agleason6/Street-Solar-Charger/inductor.jpg

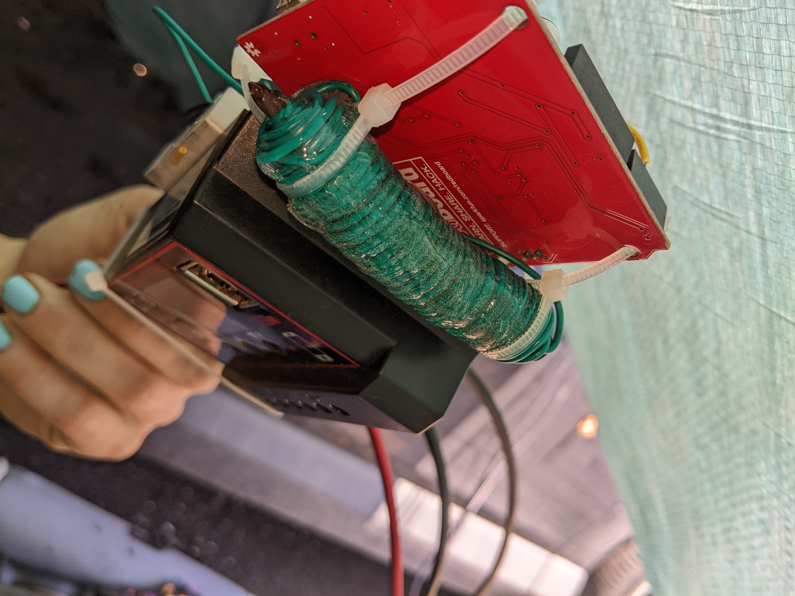
inductor.jpg
