agleason6/Street-Solar-Charger/circuit.jpg

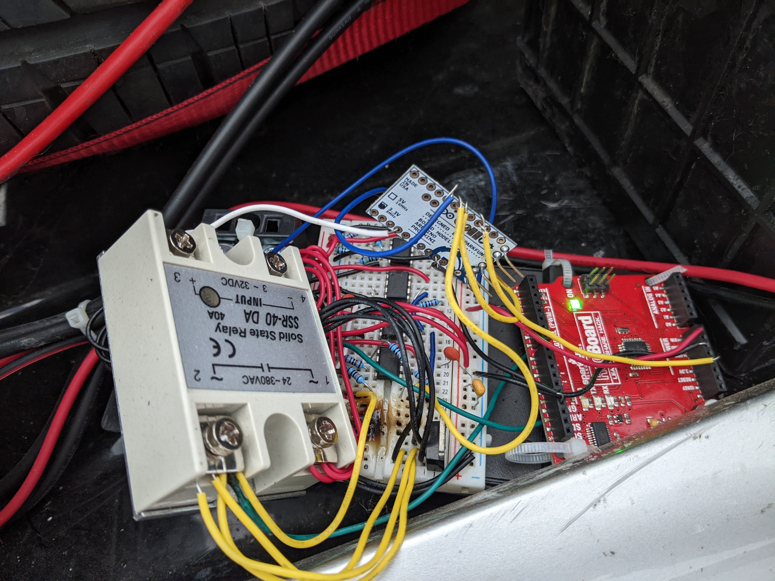
circuit.jpg
