agleason6/Street-Solar-Charger/overall.jpg

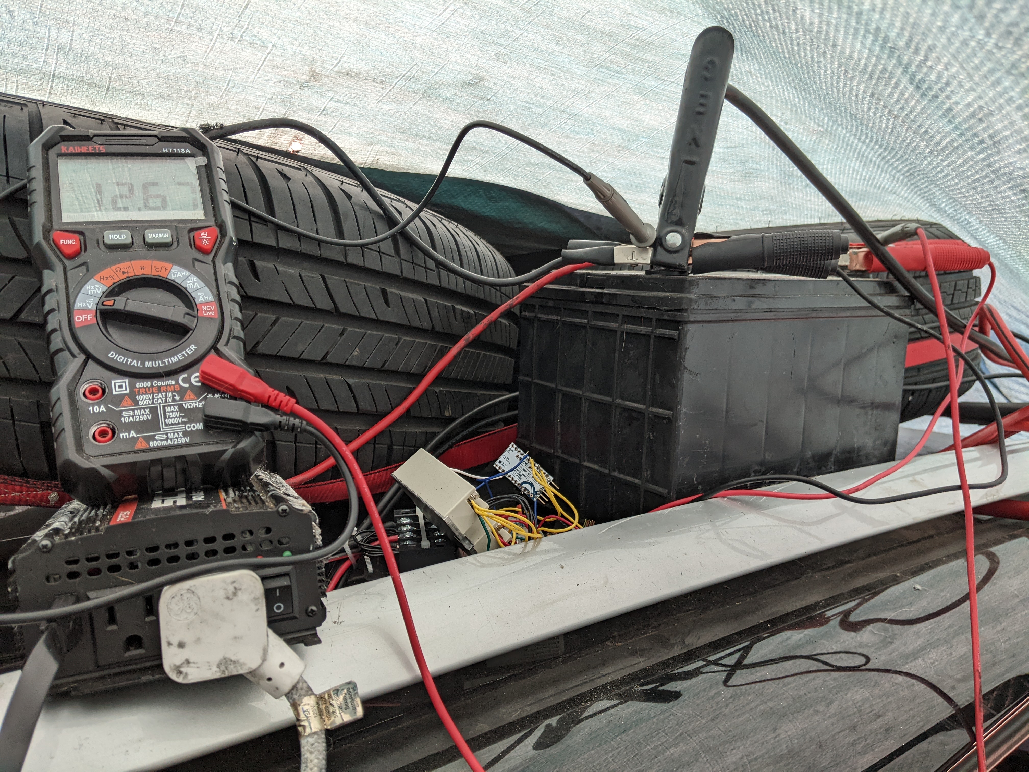
overall.jpg
