agleason6/Street-Solar-Charger/Street_Solar_Schematic.pdf

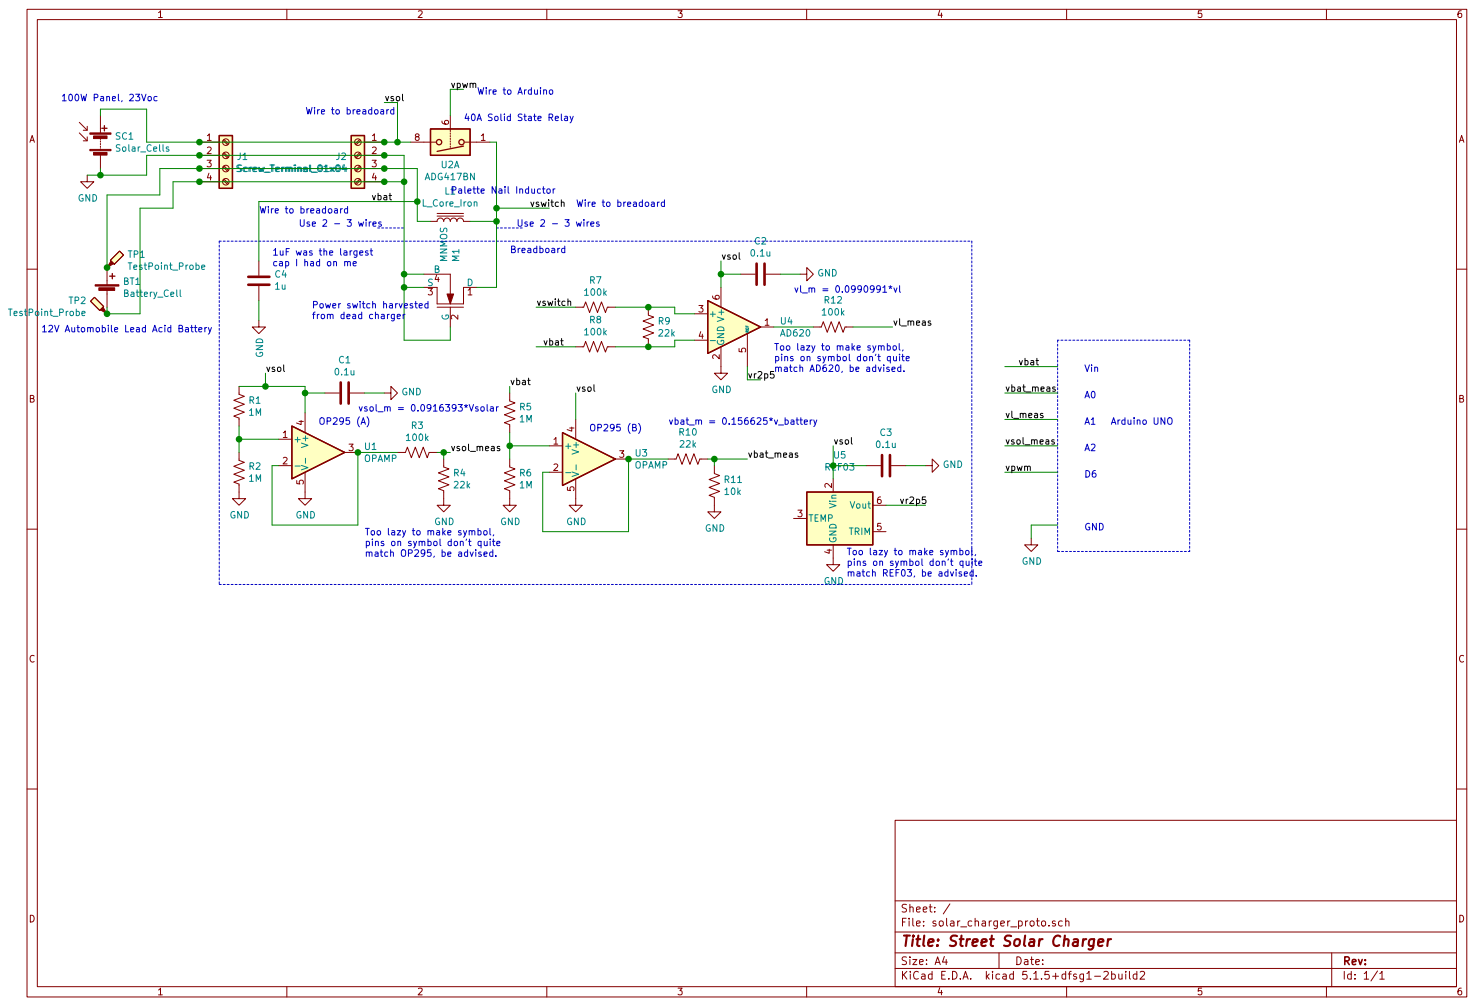
[picture p4: page 1]

OP295 (B) Palette Nail Inductor 40A Solid State Relay

3 | J2 Screw_Terminal_01x04 | | 3

pins on symbol don't quite match REF03, be advised. 1uF was the largest
cap I had on me

pins on symbol don't quite match AD620, be advised. Too lazy to make symbol,

Id: 1/1 Title: Street Solar Charger
