agleason6/Street-Solar-Charger/(commit log)

2022-07-13 Uploaded Arduino sketch and schematic
    Going to copy paste readme next
2022-07-13 Added pictures of street solar charger
